ChoiHwanHyo/Iot_team6/2주차 진행상황/2주차 진행상황_허유진/HW_TEST/HG7881_output.jpg

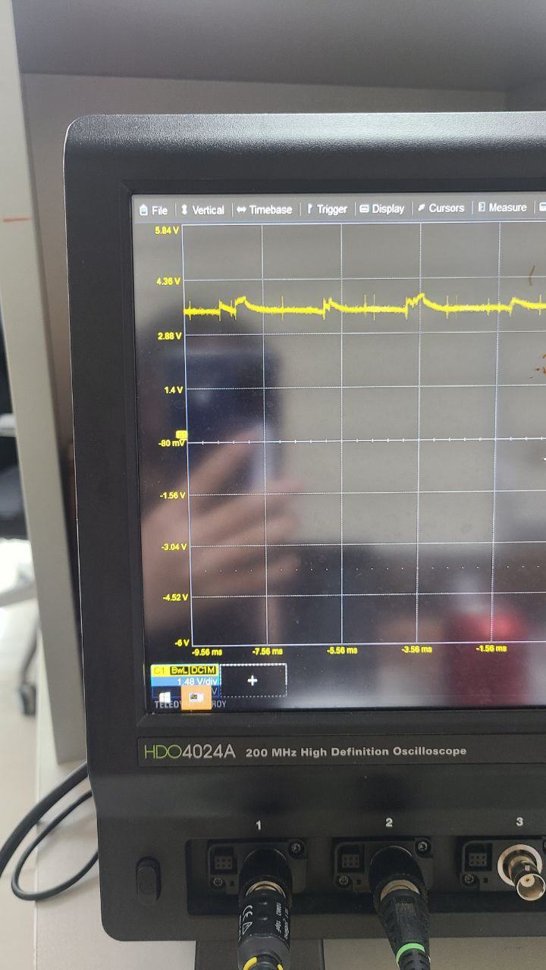
2주차 진행상황/2주차 진행상황_허유진/HW_TEST/HG7881_output.jpg
