ChoiHwanHyo/Iot_team6/README.md

# Iot_team6
## KAU IOT project "스마트 어항"
> 자동 먹이주기, 자동 물갈이, 이상수온 알림 등의 기능이 포함된 어항
