ChoiHwanHyo/Iot_team6/feeding_machine.stp

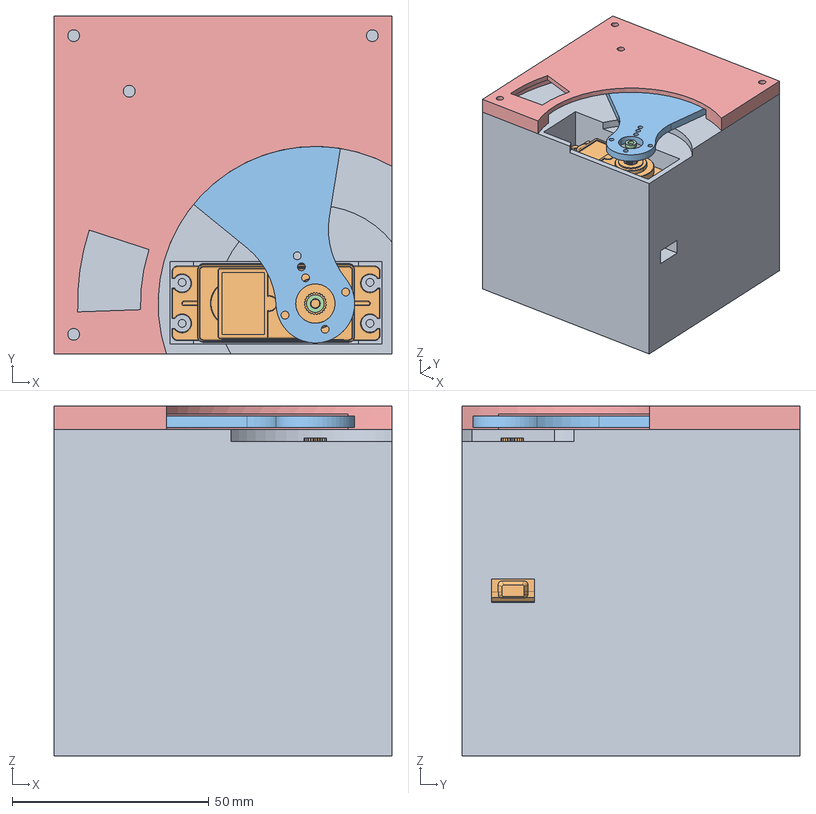
[picture p4: CAD file, 2022-06-09]
feeding_machine.stp
86.0 x 86.0 x 89.0 mm
