ChoiHwanHyo/Iot_team6/(commit log)

2022-05-27 Create 1주차 한 내용.txt
2022-05-27 Create 2주차 한 내용.txt
2022-05-27 Create 스마트 어항 목표.txt
2022-05-30 Create 3주차 한 내용.txt
2022-06-03 Create 3주차 진행상황_허유진
2022-06-09 Update 스마트 어항 목표.txt
2022-06-09 yj add
    [BOM.xlsx]
